AndrejChoo/CPLDCtrum/hardware/img/Board_DOwn.jpg

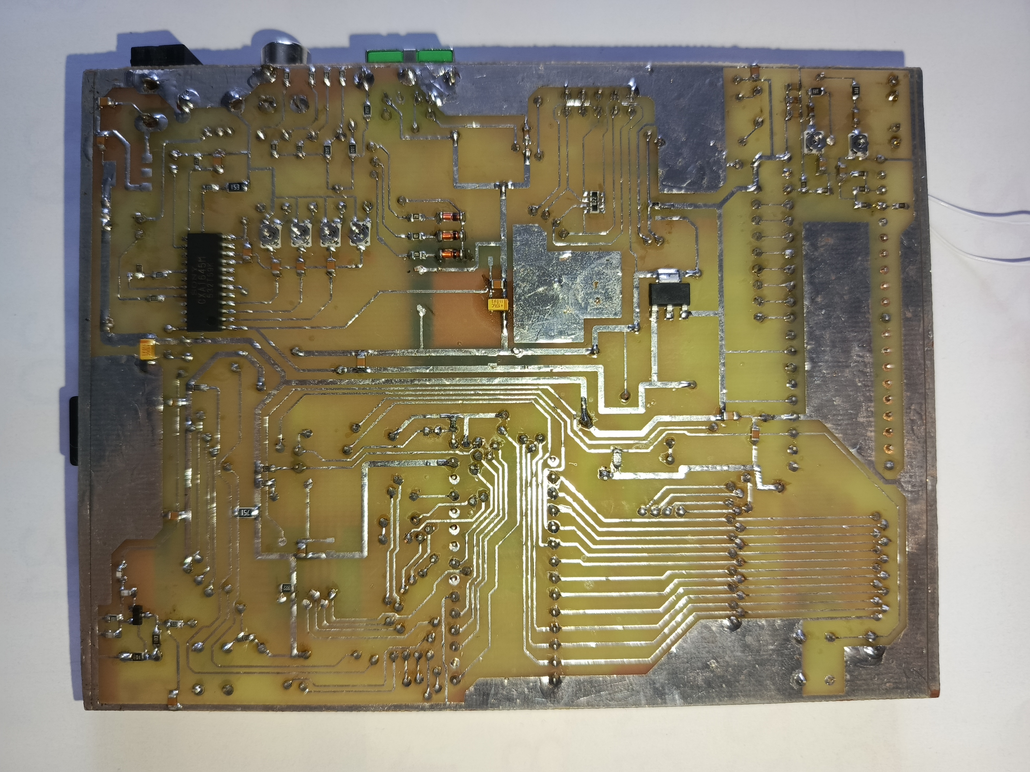
hardware/img/Board_DOwn.jpg
