AndrejChoo/CPLDCtrum/hardware/img/Board_Up.jpg

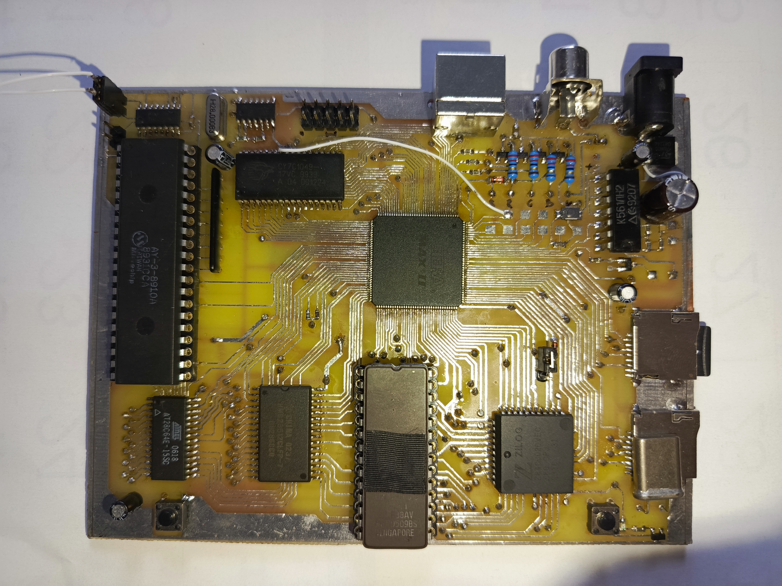
hardware/img/Board_Up.jpg
