AndrejChoo/CPLDCtrum/hardware/sch/Schematic_CPLDCtrum_2024-08-06.pdf

# A10 44 A9 43 A8 42 A7 41 A6 40 A5 39 A4 38 A3 37 A2 36 A1 35 A0 34

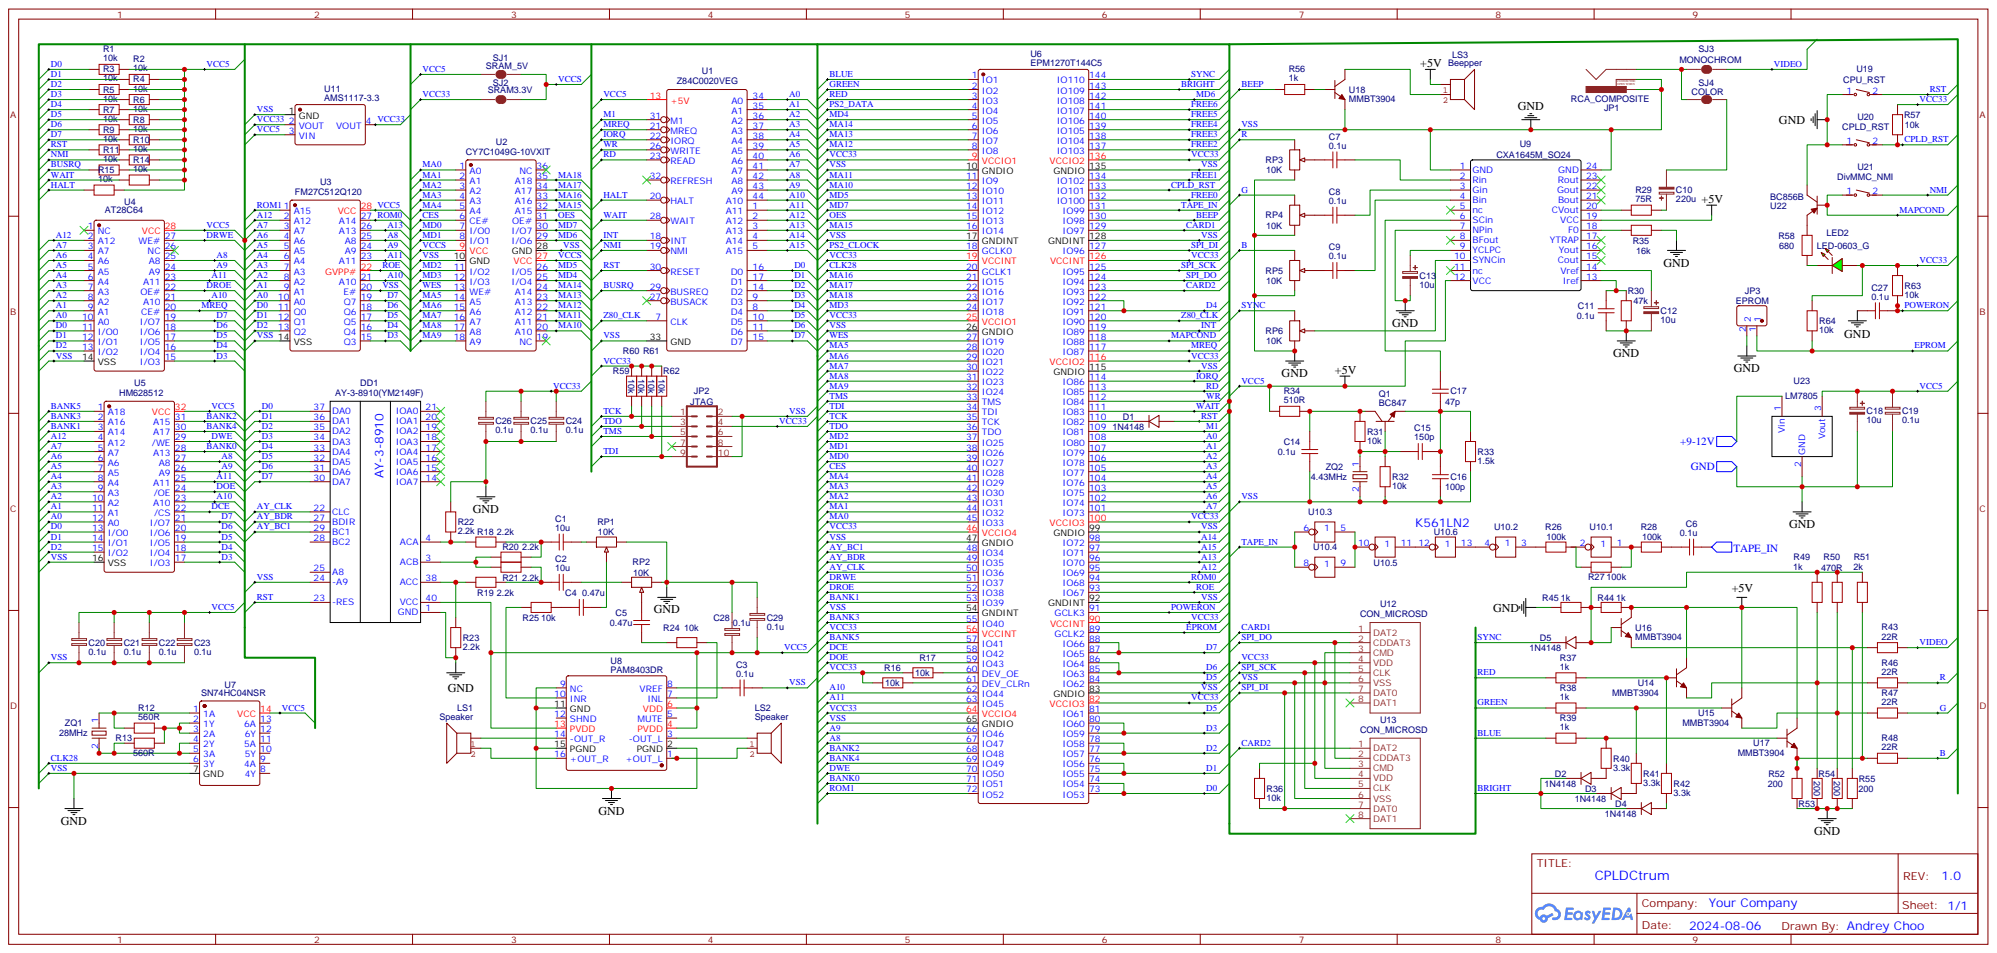
[picture p4: page 1]

Drawn By: Andrey Choo
