AndrejChoo/CPLDCtrum/(list of files, drawings)

Other design files:
hardware/pcb/CPLDectrum.lay6
